mdkaba/Hovercraft/README.md

# Hovercraft
Engineering Team design Competition (Autonomous hovercraft)

The purpose is for the hovercraft to finish a certain track that is constrained by various limits that must be adhered to during the competition.
