mdkaba/Hovercraft/PDR_Presentation.pptx

## ENGR290 PDR Team 2

March 9th, 2022

By
Abdullah
Omar
Jaskirat
Mohamed
Mamadou
Maya

## Specifications

| Wish | Preferred | Demand
Autonomous | | | x
Succeed in first attempt | | x
Hover gap of 3-5 mm | | | x
Complete the track in under 45 seconds | | x
Complete the track in under 2 minutes | | | X
Minimum possible # of components | | x
Avoid collisions | | | X
| | | X
Able to get un-stuck | | x

## Requirements

- Autonomous
- Maximum time : 2 minutes
- Minimum components
- Accomplish three U-turns
- 3 obstacles, highest: 3mm
- Achieve a high score based on: d/(Nc ×t)

## Design and Selection

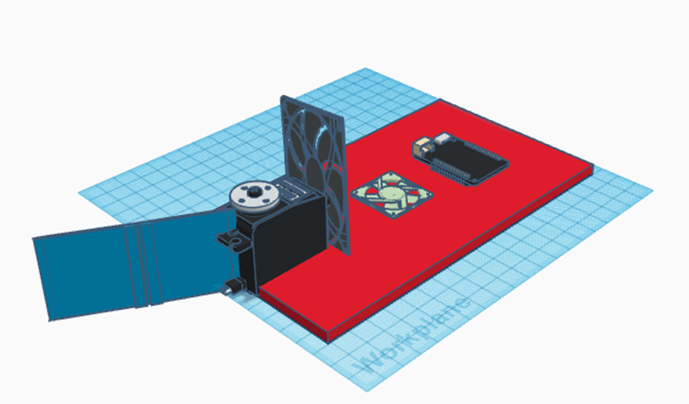
[picture p1: figure]
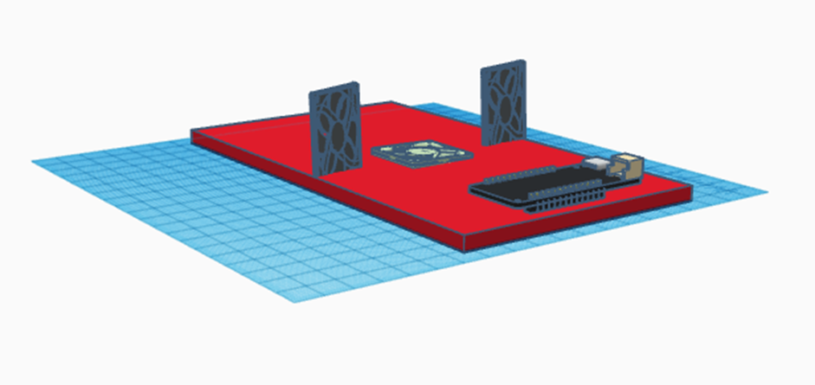
[picture p2: figure]

Model 1

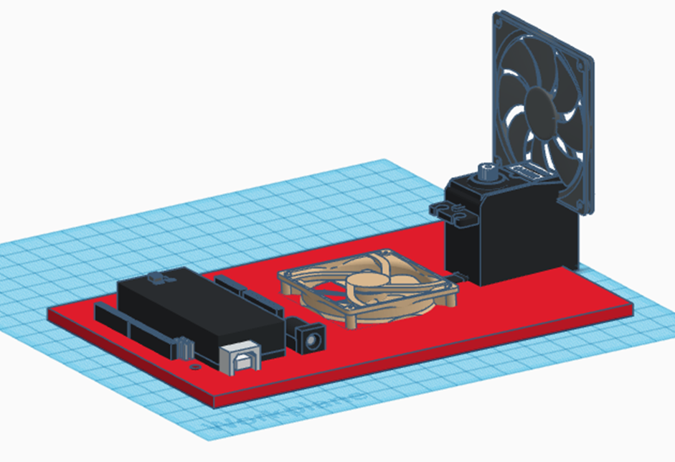
[picture p3: figure]

Model 2

Model 3

## SWOT Analysis

| Strengths | Weaknesses | Opportunities | Threats
1. 2 fans + servo + rudder | Rudder: effective and customizable Fan for thrust | 3 components | Components provided 3 attempts Access to track Competition Score Formula | 3 obstacles 3 U-turns Crashing into a wall
2. 3 fans | High Thrust Low Angular Acceleration High Moment of Inertia | 3 components Heavy Adjust center of mass
3. 2 fans + servo | Back up Fan for thrust | Sharp unstable turns Challenging implementation 3 components

## WOT Analysis

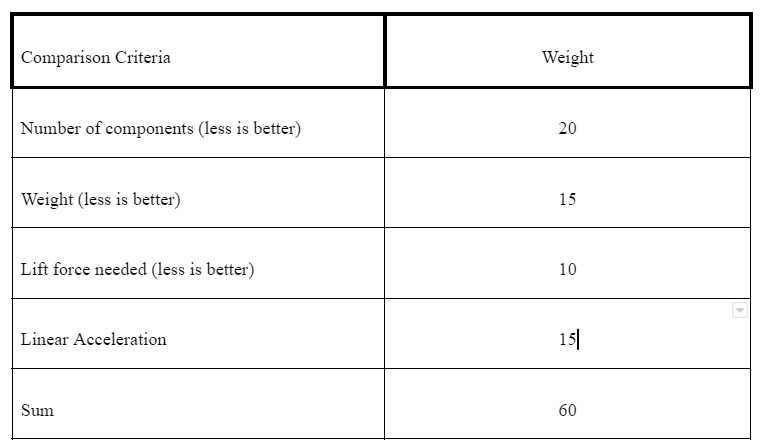
[picture p4: figure]

## Slide 7

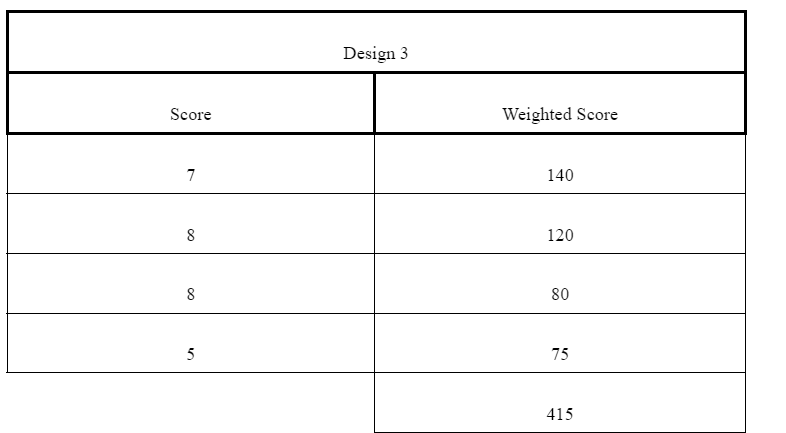
[picture p5: figure]
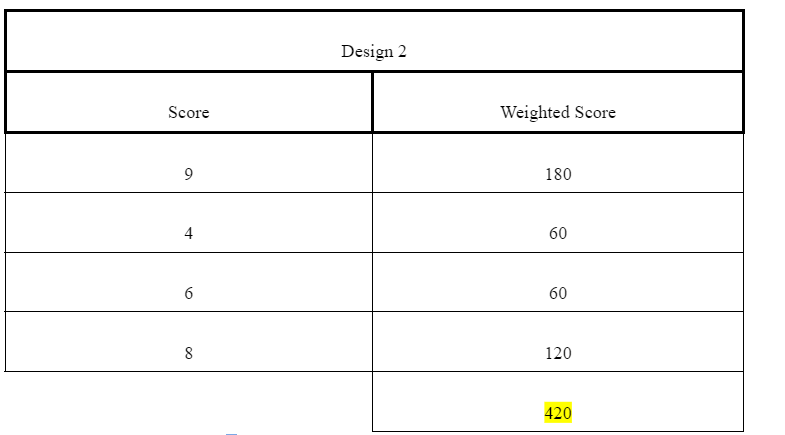
[picture p6: figure]
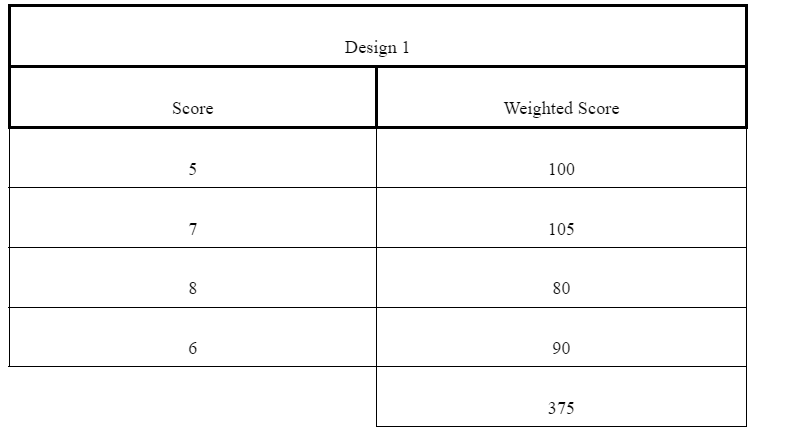
[picture p7: figure]

## AHP

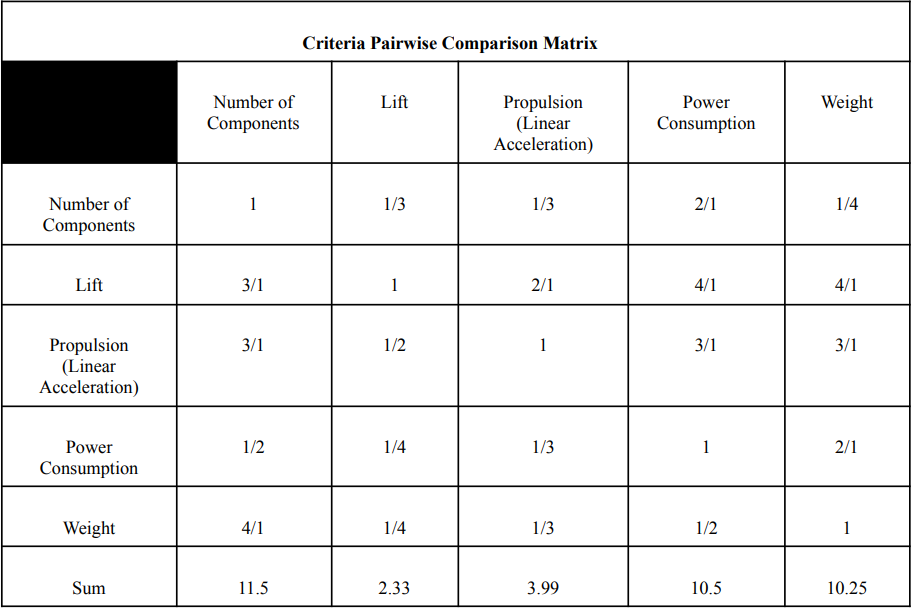
[picture p8: figure]
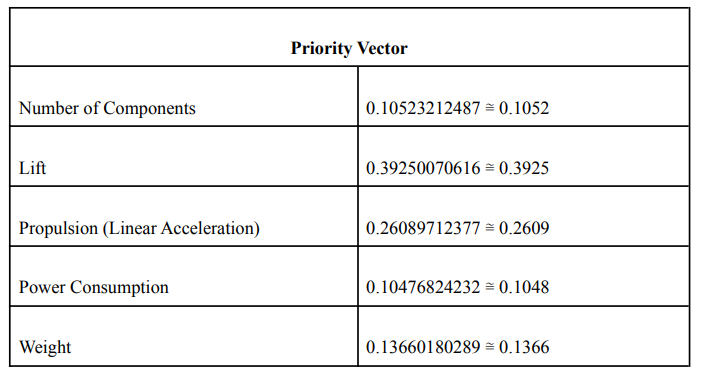
[picture p9: figure]

## Final Decision

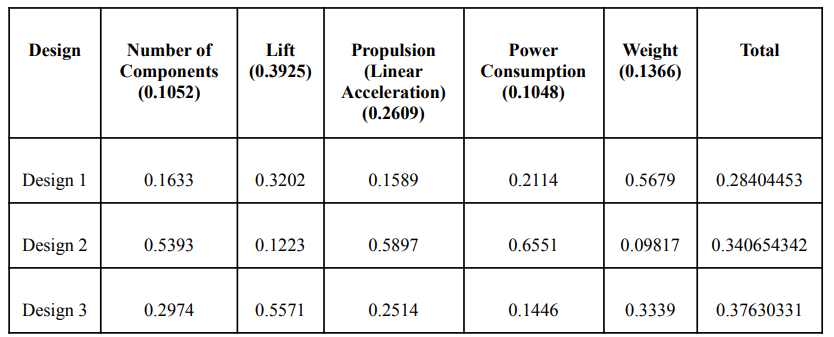
[picture p10: figure]

## Progress

- 1. Define Problem ✔
- 2. Brainstorm ✔
- 3. Research & Ideas ✔
- 4. Identify Criteria ✔
- 5. Explore Possibilities ✔
- 6. Select Approach ✔
- 7. Develop a Design Proposal ✔
- To do: 8. Make Prototype
- 9. Test and Evaluate
- 10. Refine
- 11. Final Design
- 12. Communicate Results

## Schedule

- Gantt Chart

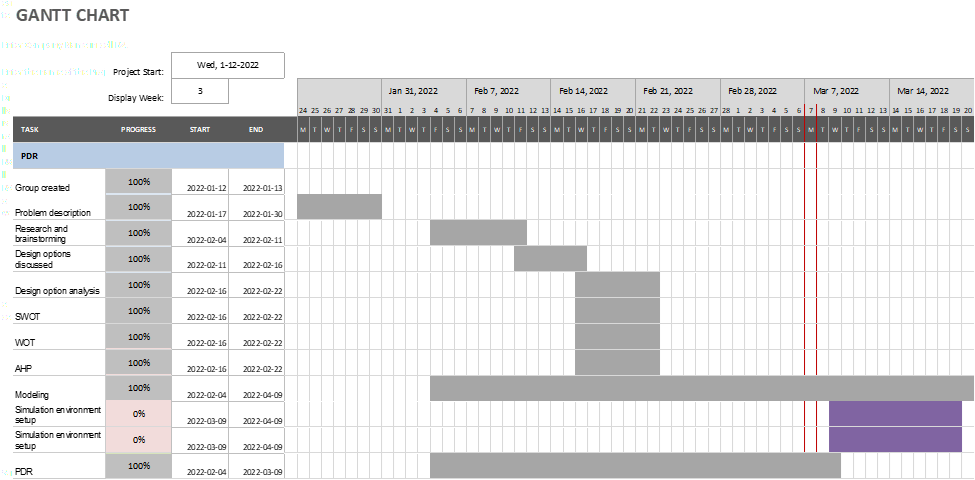
[picture p11: figure]

## THANK YOU
